mrmorphic/led-cylinder/Notes on cyclinder project.odt

LED cyclinder

# Architecture

Components:

- Propeller controller (@80MHz)
- LED grid – custom 16x8 with RGB LEDs, 8 bits per colour per pixel
- Nunchuck input controller for configuration
- LCD display for configuration
- Other hardware as required by processes, including:
- audio input, digitised
- audio output
- light sensor
- SD card reader
- ethernet connection

## IO Logical Map

- LED grid will require 10 IO pins for driving TLC5940 + 2 pins for encoded row select. 6 more pins if additional driver chips are required, minus 1 for encoded row.
- 2 channel A/D will require 4 IO pins – microphone/audio input, light level. Consider using A/D conversion capability of counter on propeller instead. Microphone is mono, but audio input is stereo and will require dual channels.
- 2 pins for boot/serial connection
- 2 pins for i2c (serial ROM, nunchuck, LCD driver)
- 2 pins stereo output
- 4 pins for ethernet chip (PropTCP library for driving ENC28J60 chip)
- ? pins for SPI connection to SD card socket

Total pins: 30 of 32 pins

@todo: check LED driver connection logic, verify logic to drive it and pin requirement

@todo: test driving LCD, determine if it can serial share. Borrow Arduino driver if necessary.

# Hardware

@todo: determine physical dimensions of LED cylinder

@todo: determine how cylinder will be mounted

@todo: determine how other hardware is mounted, and connections to controller board

## Physical I/O Port Map

These are the physical pins allocated to date

IO Port Bit | Pin | Purpose | Description
0 | 1 | | LED grid BLANK
1 | 2 | | LED GSCLK
2 | 3 | | LED XLAT
3 | 4 | | LED SCLK
4 | 5 | | LED SIN red top
5 | 6 | | LED SIN green top
6 | 7 | | LED SIN blue top
7 | 8 | | LED SIN red bottom
8 | 13 | | LED SIN green bottom
9 | 14 | | LED SIN blue bottom
10 | 15 | | LED row select 0
11 | 16 | | LED row select 1
12 | 17 | | LED enable
13 | 18 | | reserved
14 | 19 | | reserved
15 | 20 | | reserved
16 | 21 | | reserved
17 | 22 | | reserved
18 | 23 | | LCD BL
19 | 24 | | LCD E
20 | 25 | | LCD R/W
21 | 26 | | LCD RS
22 | 27 | | LCD D4
23 | 28 | | LCD D5
24 | 33 | | LCD D6
25 | 34 | | LCD D7
26 | 35 | | IR receiver [temp]
27 | 36 | | Blue test LED
28 | 37 | I2C | SCL - clock
29 | 38 | | SDA - data
30 | 39 | Serial | Serial Tx
31 | 40 | | Serial Rx

# Control

Cog0 is the control cog. It is responsible for:

- start-up
- allocating buffers for LED display, config command queue and LCD buffer and resources
- initiating processes for LED display, nunchuck and LCD
- accepting config commands from Config process, and actioning them
- Process selection and scheduling in the absence of configuration

# Config

2 cogs are used for configuration:

- Input from the nunchuck.
- LCD management

## Nunchuck

Nunchuck has two modes. One button (tbd) when pressed activates config mode. In this mode, the nunchuck uses the LCD to let the user choose options, particularly around processes. Sub-processes on other cogs may be used to support this (e.g. read files from SD card so user can pick an image). User selections are sent to the control process via the config command queue. These are then actioned by control.

When not in config mode, raw nunchuck serial stream is stored in a rotating buffer, so that processes can use the nunchuck as a process input.

## LCD

The LCD driver will reside in a cog and accept display commands. Commands have a source. The config process that is managed by the nunchuck process take precedence over process display on the LCD, so that in config mode the LCD may temporarily switch to displaying config information.

When not in config mode, the LCD will execute display commands and serve as an output, or blank if there are no display commands.

The LCD display is HD44780 compatible. It requires 11 pins to drive. These are driven by an Atmel328P microcontroller that acts as an I2C slave. It accepts commands from the main controller over I2C, with instructions to write values to the display. Commands sent to the LCD controller cog are sent via I2C to the secondary display controller.

# LED Driver

## Overview

The LED cyclinder is a grid of 16x8 RGD common anode LEDs. Physically it is arranged as 16 vertical columns by 8 horizontal rows (wrapped around).

Driving the columns are TLC5940 constant current LED drivers. Each TLC5940 is capable of driving 16 LED outputs. These outputs are connected to the columns of the cyclinder, with each TLC5940 driving a different colour. Note that each colour component has a different voltage drop and hence requiring slightly different adjustments per chip.

Rows of the cylinder are multiplexed. The top 4 rows are driven by 3 TLC5940's, and the bottom 4 rows are driven by 3 more. Half of a 74HC139 dual 1-of-4 decoder is used to select one of the 4 top rows, and one of the 4 bottom rows. Hence two rows are displayed at any point in time. (1-of-8 decoding results in too low intensity on the LEDs) The LEDs may be overdriven since they are not on fully, in order to increase intensity. LED supply for each 4 row group is provided by a TIP32 PNP power transistor. Rated at Ic 3A, each row when fully enabled will consume 1.44A assuming LEDs are overdriven to 30mA.

The TLC5940 devices are supplied at 5V. The Propeller is supplied at 3.3V, but output levels are sufficient to drive the TLC5940's directly.

The software driving the LED cylinder runs on two cogs. The first cog handles a fast, constant rate PWM clock to all TLC5940's simultaneous. Since this device uses 12 bits for colour intensity, it takes 4096 PWM clocks to perform one complete PWM scan.

The second cog takes care of outputting data to the TLC5940's. Data is clocked into the devices while the PWM cycle takes place, since the input shift register in the TLC5940 is independent of the PWM registers. The data loaded is always one row ahead of the data being driven on the LEDs: while the PWM cycle for row n is clocked out, data for row n+1 is being loaded. Once a row is loaded, the second cog waits for the PWM cog to complete it's full PWM scan, at which point the new data is latched, the new PWM scan begins, and the cycle repeats.

The frame buffer data is stored in shared RAM on the propeller. For efficiency of access, pixel data is stored in 32-bit words, with the high 8 bits unused. Red, green and blue 8-bit values are stored in the next 3 bytes (red being most significant). Row 0 (top) is stored first, with each row occupying 16 32-bit words.

Dual buffering may be considered if flickering is an issue.

## Timing

Assumes Propeller max clock of 80MHz

Measure | Value
CPU clock cycle time | 130ns
Min Instruction execution time (4 CPU clocks per instruction) | 520ns
Min Instruction frequency | 20MHz
Max GSCLK frequency | 30MHz
GSCLK frequency given 3-instruction loop | 641KHz
PWM cycle length (4096 clocks) | 6.3 ms
Display data load cycle length (192 bits) | Min 300 ms
Percentage load to GSCLK cycle

Some of these times may be invalid since the driver configuration and logic have been changed.

# Discrete Inputs

There will be one or more objects that support discrete inputs, which include:

- mono/stereo input
- microphone input
- light sensor

The input process will read values from these devices and store current values in a buffer. Processes may operate on these values. When in use, the intent is to run A/D conversions at maximum speed, so additional processes like spectrum analysis can execute in another process in real time.

The input process only feeds a currently running display process. It does not affect control or config processes.

@todo Finalise the discrete inputs

# Processes

One cog allocated to currently running process (not including config process). Spare cogs can be used in support of main process.

## VU Meter

This is a display process that continually reads spectrum analysis results, and displays these on columns of the LED cylinder. Supports colour shading.

## Patterns

Various arbitrary pattern processes are possible.

Wavey sea with colour

Point swarms flowing in a direction, or back

Think about angular based algorithms instead of polar.

Paint dripping or washing down. Starts at the top swirls down.

@todo investigate algorithms for display of moving patterns, e.g. audio player or swarm patterns.

## Games

Games are possible. Think tetris. Using colour selection. Using nunchuck as input.

@todo: come up with some specifics.

## Spectrum Analysis

This is a service process. It reads data from input process (e.g. audio) and performs a spectrum analysis, depositing results in a buffer.
