mrmorphic/led-cylinder/circuit/todo.md

# LED Driver

## interlacing

* Add 3 more TLC5940, with top 4 and bottom 4 rows handled by groups of 3 drivers.
* Change 74HC138 for a 74HC139 dual 2-4 decoders.

## voltages

* TLC5940 and other driver logic will work at 5V. Propeller to work at 3V. Prop  driving TLC5940 at 5V is tested and works.
* Add a 5V regulator as well as the 3.3V regulator.

# Nunchuck

# LCD Display
