mrmorphic/led-cylinder/(commit log)

2011-06-25 ENHANCEMENT: frame manipulation library
2011-06-25 MINOR: added frame control
2011-06-25 ENHANCEMENT: initial startup, sunrise attempt, but far too slow at present
    [DisplayStartup.spin]
2011-06-25 Removed ATmega code, as its no longer part of the circuit
    [lcd_driver_atmeta328.pde]
2011-06-25 MINOR: updated schematic
    [LED cylinder_v2.sch]
2011-06-25 ENHANCEMENT: major refactor and tidy; remove IR control, replaced with nunchuck, extra displays, LCD updates and better control
    [LedCylinder.spin]
2012-04-14 ENHANCEMENT: Added modified ADC driver for MCP3202
2012-04-14 MINOR: included MCP3208 fast ADC driver for reference, not being used
2012-04-14 MINOR: removed old driver
2012-04-14 ENHANCEMENT: complete replacement of the startup sequence, since the old one was an idea that just didn't work out.
    [DisplayStartup.spin]
2012-04-14 MINOR: updated comments about cog and pin usage
2012-04-14 MINOR: Remove displays that are no longer going to be developed
    [LedCylinder.spin]
2012-04-14 ENHANCEMENT: Added ADC support. It's a bit shonky because the LED cylinder display itself generates electrical noise that affects the ADC circuitry. ADC readings from microphone are not reliable.
    [LedCylinder.spin]
2012-04-14 ENHANCEMENT: kill startup after it has executed, and switch to rain. Also update ADC. And implement timeout on mode display to say something else
2012-04-15 MINOR: lots of tweaking to try and remove interference from the mic/ADC combo, with only limited success. Includes a last-n sample buffer which is averaged and compared against spot sample
2012-06-23 MINOR: implement display_control and nunchuck save
    display Control lets displays terminate, automatically switching to the next display when they are finished.
    Saving nunchuck data means displays could use that. Both display control and nunchuck pointers are saved
    to globalBuffers for displays to use
2013-11-09 ignore circuit backup
